4lhc/TWIP-Self-Balancing-Robot/img/DS.png

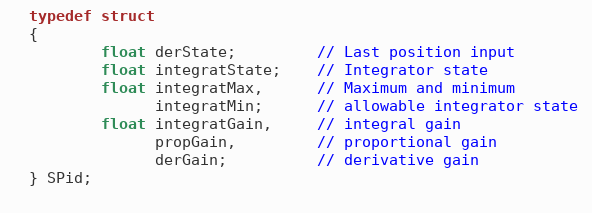
img/DS.png
