4lhc/TWIP-Self-Balancing-Robot/img/IMG_20191208_080504.jpg

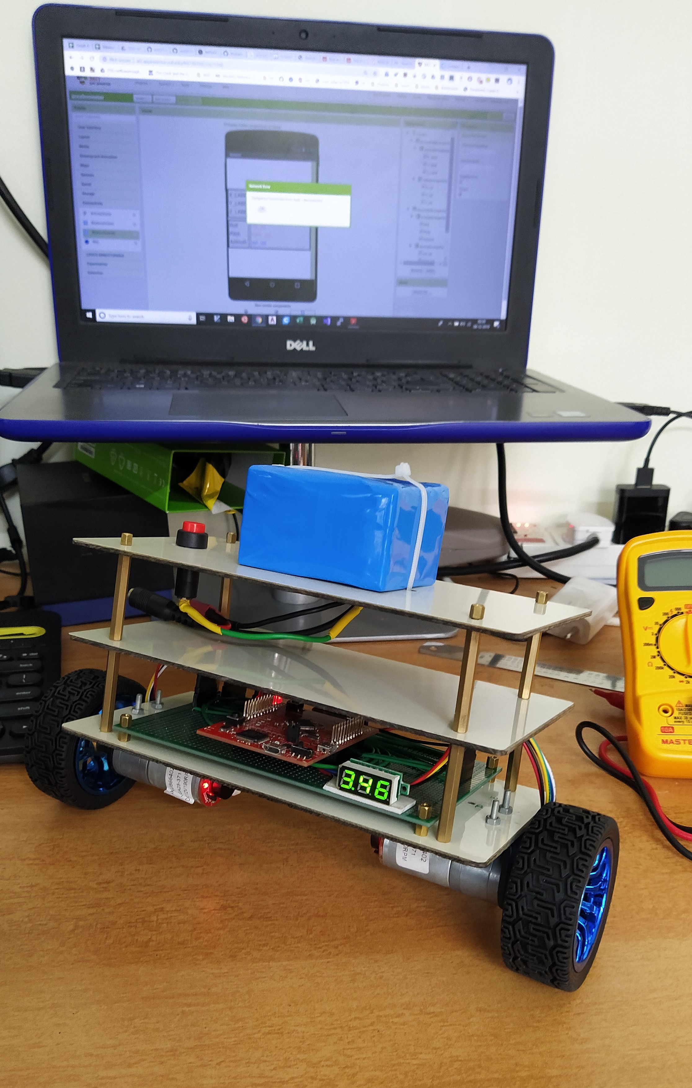
img/IMG_20191208_080504.jpg
