4lhc/TWIP-Self-Balancing-Robot/img/IMG_20191208_180454874.jpg

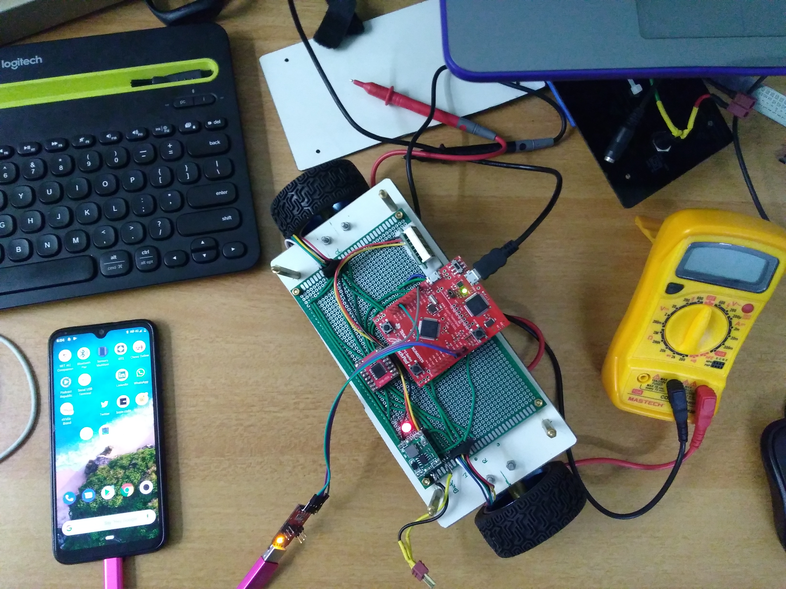
img/IMG_20191208_180454874.jpg
