4lhc/TWIP-Self-Balancing-Robot/img/IMG_20191208_180501446.jpg

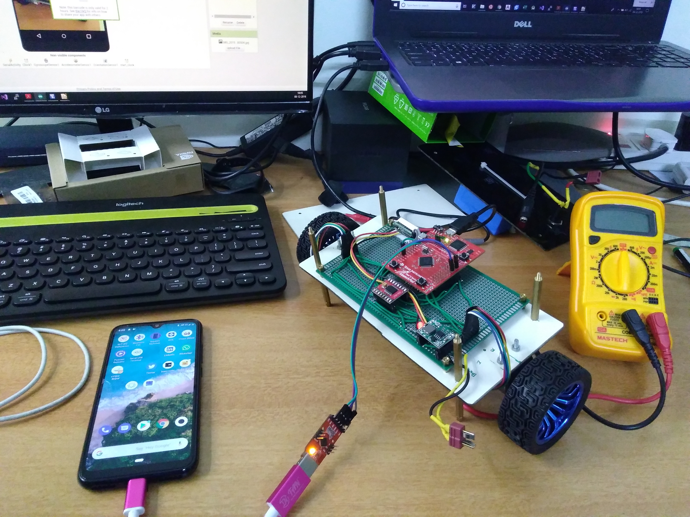
img/IMG_20191208_180501446.jpg
