4lhc/TWIP-Self-Balancing-Robot/docs/BOM.pdf

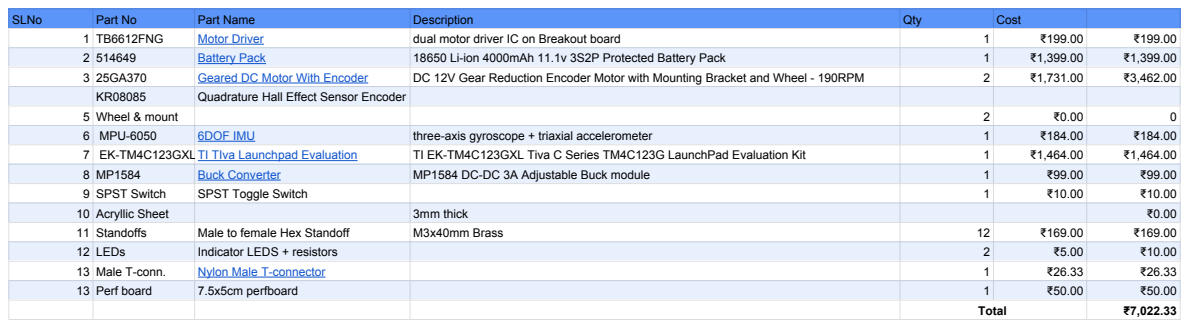
[picture p17: page 1]
SLNo; Part No; Part Name; Description; Qty; Cost; 1 TB6612FNG; Motor Driver; dual motor driver IC on Breakout board; Battery Pack; 18650 Li-ion 4000mAh 11.1v 3S2P Protected Battery Pack; Geared DC Motor With Encoder; DC 12V Gear Reduction Encoder Motor with Mounting Bracket and Wheel - 190RPM; Quadrature Hall Effect Sensor Encoder; 5 Wheel & mount; 6 MPU-6050; 6DOF IMU; three-axis gyroscope + triaxial accelerometer; 7 EK-TM4C123GXLTI TIva Launchpad Evaluation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
