4lhc/TWIP-Self-Balancing-Robot/schematics/Schematics_V1.pdf

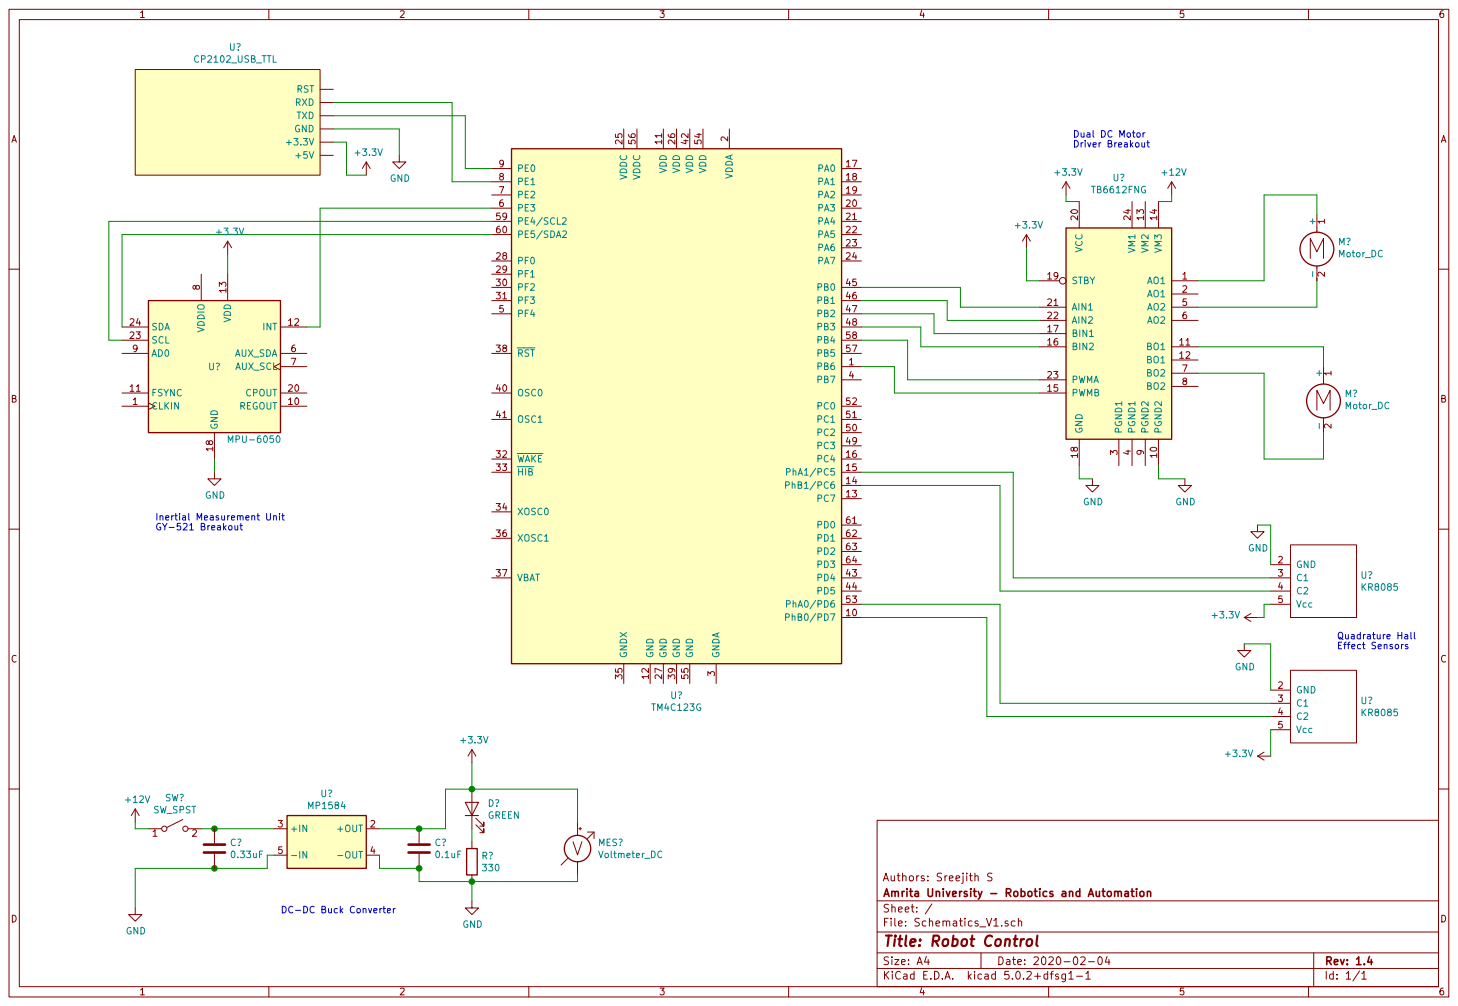
[picture p18: page 1]

Authors: Sreejith S
File: Schematics_V1.sch Sheet: / Amrita University - Robotics and Automation

DC-DC Buck Converter

Id: 1/1 Title: Robot Control
