4lhc/TWIP-Self-Balancing-Robot/schematics/Schematics_V1.kicad_pcb

## KiCad design kicad/deadman-switch.sch

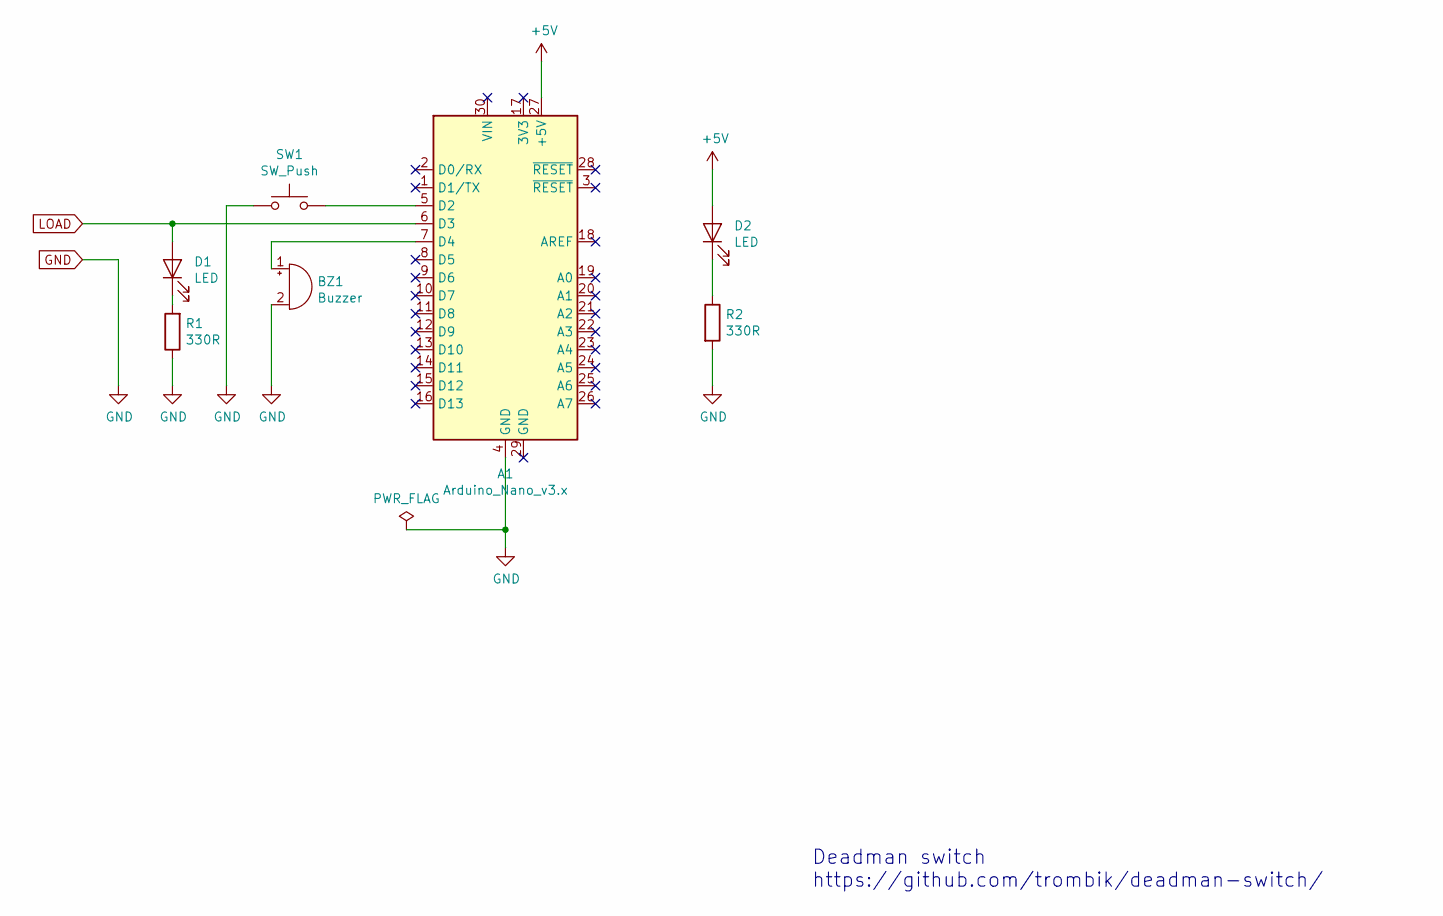
[picture p19: schematic deadman-switch.sch]

Parts:
A1: Arduino_Nano_v3.x; Arduino_Nano
BZ1: Buzzer
D1, D2: LED
R1, R2: 330R
SW1: SW_Push

Connections:
+5V: A1.27 (+5V), D2.2 (A)
GND: A1.4 (GND), BZ1.2 (+), R1.1, R2.2, SW1.1
LOAD: A1.6 (D3), D1.2 (A)
unnamed: A1.5 (D2), SW1.2
unnamed: A1.7 (D4), BZ1.1 (-)
unnamed: D1.1 (K), R1.2
unnamed: D2.1 (K), R2.1

Notes on the sheet:
Deadman switch https://github.com/trombik/deadman-switch/
