4lhc/TWIP-Self-Balancing-Robot/code/pid.c

/***********************************************************************
File Name            : pid.c
Project              : Self Balancing Robot
Author               : Sreejith S, Karthik
Date                 : 08 Dec 2019
Platform             : Tiva Development Kit EK-TM4C123GXL
Descirption          : Code for pid controller
***********************************************************************/

#include "pid.h"



float UpdatePID(SPid* pid, float error, float position)
{
        float pTerm, dTerm, iTerm;
        pTerm = pid->propGain * error; // calculate the proportional term
        // calculate the integral state with appropriate limiting
        pid->integratState += error;
        // Limit the integrator state if necessary
        if (pid->integratState > pid->integratMax)
        {
                pid->integratState = pid->integratMax;
        }
        else if (pid->integratState < pid->integratMin)
        {
                pid->integratState = pid->integratMin;
        }
        // calculate the integral term
        iTerm = pid->integratGain * pid->integratState;
        // calculate the derivative
        dTerm = pid->derGain * (pid->derState - position);
        pid->derState = position;
        return pTerm + dTerm + iTerm;
}
