4lhc/TWIP-Self-Balancing-Robot/code/imu.h

/***********************************************************************
File Name          : time.c
Project            : Self Balancing Robot
Author             : Sreejith S
Date               : 12 Dec 2019
Platform           : Tiva Development Kit EK-TM4C123GXL
Description        : Init MPU6050 and get readings
***********************************************************************/

#ifndef IMU_H
#define IMU_H


#endif
